NickeyJin/ZhiYuanZhanDui/docs/00-项目总览.md

# 00 项目总览

> 队伍：**致远战队**
> 机器人：四轮麦克纳姆轮全向底盘 + 四轴机械臂（拣放方块）
> 主控：STM32F103C8T6
> 遥控：PS2 无线手柄
> 文档约定：本目录内所有 `.md` 按「机器人功能完成的时间顺序」排列，每篇由若干**功能板块**组成
> （二级标题 = 功能名，正文 = 功能描述 + 开发历程）；开源项目说明见 `05-开源组件与参考资料.md`。

---

## 文档索引（按功能完成时间从早到晚）

| 文档 | 覆盖的功能板块 | 时间段 |
|---|---|---|
| [01-主控与电源平台.md](01-主控与电源平台.md) | 主控与调试接口 / 引脚分配 / 供电与共地 / 构建与烧录工具链 | 10-06 ~ 10-11 |
| [02-底盘与全向移动.md](02-底盘与全向移动.md) | 电机驱动与 PWM / 麦轮逆运动学 / 起步补偿 / 现场配速与整定 | 10-11 ~ 10-19 |
| [03-遥控与现场调参.md](03-遥控与现场调参.md) | PS2 手柄协议 / 微秒级时基 / 按键分工 / 现场调参旋钮 / 灯语 | 10-06 ~ 10-19 |
| [04-机械臂与夹取.md](04-机械臂与夹取.md) | 四路舵机与限位 / 上电初始位 / 放块宏 / 机械臂按键设计 | 10-15 ~ 10-19 |
| [05-开源组件与参考资料.md](05-开源组件与参考资料.md) | 第三方组件完整说明（规则要求的中期考核说明项） | — |

> 另有队友撰写的硬件侧日志《智能车设计与制作日志.md》（电源、PCB 底板、结构件、整车重量与成本），与本目录并存。

---

## 1. 简单介绍

一台用 PS2 手柄遥控的全向移动小车：底盘四个 60mm 麦克纳姆轮由 3 片 DRV8833 驱动 4 个 TT 减速电机，
可以前后、左右平移（存疑？）和原地自转；车上一只四舵机机械臂（肩 / 肘 / 腕 / 夹爪）负责把 30mm 立方体（能量单元）夹起并放进目标洞口，按一次 `R2+R1` 就能完成“回放块位 → 三轴到位 → 张爪丢块 → 回到原姿态”。

## 2. 设计约束（来自比赛规则）

| 约束 | 数值 | 对设计的影响 |
|---|---|---|
| 开局外形 | 高 ≤ 210mm | 机械臂必须能在开局收成平躺折叠姿态 |
| 运行中包络 | ≤ 445×400×450mm 或 550mm 球 | 臂展按“小臂 + 腕”分两段控制，不做大回转 |
| 整机重量 | ≤ 2.0kg | 机械臂选 MG995 + SG90 的轻量组合 |
| 抗跌落 | 150~200mm 自由落体不掉件 | 夹爪闭合位留 6mm 小孔靠摩擦夹持 |
| 成本 | 新生组不推荐超 400 元 | 结构件改现货、3D 打印件自制 |
| 断电 | 必须适配官方无线继电器（10m 内断电） | 列为收尾项 |

## 3. 时间线一览

| 日期 | 里程碑 |
|---|---|
| 10-06 ~ 10-08 | CubeMX 工程骨架、引脚分配、PS2 协议反查（无代码提交） |
| 10-10 | DWT 微秒延时（`dwt_delay.c`），PS2 软件时序的前提 |
| 10-11 | 首次提交：八路 PWM 底驱 + 单轮自检 + 手柄映射（`be97c94`） |
| 10-12 | 全向移动版：`vx/vy/ω` 麦轮逆解（`c858f51`） |
| 10-13 | `app.c` 拆分：`board.h`、`diag.c`，控制回路改成非阻塞 |
| 10-15 | 机械臂接入（`983eb4d`）：四路 TIM4 舵机 + 示教回放原型 |
| 10-16 | 夹爪实测标定（580~590µs 全闭 / 650~700µs 抓取 / 1000µs 全开） |
| 10-17 | 3D 打印机械臂放弃改现货；麦轮装反纠正；引入现场配速 |
| 10-18 | 代码精简、剥离示教模块、多固件并行编译、上电安全策略反转 |
| 10-19 凌晨 | 四路舵机限位现场标定；两连杆逆解试做后放弃 |
| 10-19 白天 | 底盘从零重构：PWM 改 1µs 分辨率、满速占空比 40%→80%、起步补偿 |
| 10-19 夜 | 肩限位重测（1072/1372µs）、上电初始位、`R2+R1` 放块宏、最终精简 |

## 4. 电控的碎碎念（已被折磨疯版）

又是凌晨了，已经有点力竭了。
回溯制作项目的过程中，其实，我自己好像基本上没有怎么写很长的代码，只是小的地方修修改改，大的地方交给AI，给它表示清楚需求，然后就放着不管了。
只能说，电控和编程还真的不是一回事情，至少，在这一个月左右的项目时期里，我学习到了很多调试的办法，知道了许多很奇怪的bug，也算是有收获吧。
所以，虽然这些文档里肯定会有AI的成分，但是，里面我还是加了不少的心路历程，还有bug调节的过程，以及为什么我想这么做。
无论结果如何，这都会是我一段难忘的经历。

——致远战队 电控 NickeyJin
