NickeyJin/ZhiYuanZhanDui/docs/05-开源组件与参考资料.md

# 05 开源组件与参考资料

> 依据比赛手册第 5 页：“将开源项目用于机器人的制作及代码编写是允许的，但必须在中期考核阶段给出完整说明。”
> 本篇为完整说明项。

## 1. 使用的第三方组件清单

| # | 名称 | 版本 / 出处 | 用途 | 是否修改 |
|---|---|---|---|---|
| 1 | STM32F1xx HAL Driver（STMicroelectronics） | **V1.1.10**（`Drivers/STM32F1xx_HAL_Driver/`，`__STM32F1xx_HAL_VERSION` 主/次/修订 = 01/01/0A） | GPIO、TIM、RCC 等外设驱动，`HAL_GetTick()` 时基 | 未修改，仅调用 |
| 2 | CMSIS-Core + STM32F1xx Device Headers | `Drivers/CMSIS/`（含 `LICENSE.txt`），`__CM3_REV 0x0200`（Cortex-M3 r2p0） | 寄存器定义、`CoreDebug` / `DWT`（微秒延时） | 未修改，仅调用 |
| 3 | STM32CubeMX 生成代码 | `MyFirstCar.ioc` / `.mxproject`；`main.c`、`stm32f1xx_hal_msp.c`、`stm32f1xx_it.c`、`system_stm32f1xx.c`、`syscalls.c`、`sysmem.c`、`startup_stm32f103xb.s` | 时钟与引脚初始化骨架 | **有修改**：在 USER CODE 区手写外设初始化；`.ioc` 多次同步（10-15 新增 PB6~PB9 四路 TIM4） |
| 4 | STM32CubeMX CMake 工程模板 | `cmake/stm32cubemx/CMakeLists.txt`、`cmake/gcc-arm-none-eabi.cmake`、`CMakePresets.json` | 构建系统 | **有修改**：源文件列表增删（机械臂模块加入后又移除） |
| 5 | GNU Tools for STM32 | **14.3.1+st.2**（ST 打包，`%LOCALAPPDATA%\stm32cube\bundles\gnu-tools-for-stm32\`） | 编译器 / 链接器 / `size` | 未修改 |
| 6 | STM32CubeProgrammer CLI | `STM32_Programmer_CLI.exe`（由 `build\tools\flash.ps1` 调用，经 ST-LINK / SWD 烧录） | 烧录与校验 | 未修改 |
| 7 | 链接脚本 `STM32F103xx_FLASH.ld` | CubeMX 默认模板 | 内存布局 | **有修改**： FLASH 64K→62K；新增 RAM `.persist` 段（复位不清零区）与 Flash 末尾 2 页数据区 |
| 8 | 塔克创新 PS2 无线手柄资料 | 《PS2 无线手柄使用指导手册 V1.0.3》《锁定款一键锁定使用说明 V1.0.0》；例程头文件 `ax_ps2.h` | **仅作协议对照**（位宽 16µs、命令 `0x01 0x42`、9 字节帧、`0x73/0x53` ID），未拷贝其代码 | 否 |
| 9 | 网络参考工程 | `github.com/twzffs/stm32_mecanum_car`、`github.com/xugit0000/car_template` | 检索过，因引脚与本板不符**未采用** | 否 |
| 10 | DWT 微秒延时写法 | 社区通行做法（`CoreDebug->DEMCR |= TRCENA` + `DWT->CYCCNT`） | `dwt_delay.c` | 本项目自行实现 |

## 2. 自研部分（声明为原创）

固件：`motor.c/h`、`chassis.c/h`、`ps2.c/h`、`app.c/h`、`board.h`、`tune.c/h`、`arm.c/h`、`dwt_delay.c/h`。

工具脚本：`build\tools\direct_build.ps1`、`flash.ps1`、`read_vars.ps1`。

## 3. 结论

**除 ST 官方 HAL / CMSIS / CubeMX 模板与 GNU 工具链外，本项目未引入任何第三方 C 库。**

PS2 手柄协议部分参考厂商手册自行实现（软件模拟时序，未使用硬件 SPI）；
麦轮逆运动学公式来自通用教材，代码中的量纲化简为本项目自行处理；
机械臂未使用实时逆解，姿态由现场标定后写成常量。

## 4. 参考资料

- 塔克创新《PS2 无线手柄使用指导手册 V1.0.3》《锁定款一键锁定使用说明 V1.0.0》
- STMicroelectronics《STM32F103x8/xB Datasheet》《RM0008 Reference Manual》
- STMicroelectronics《STM32F1xx HAL Driver 用户手册（UM1850）》
- CRTC2026 中期考核规则手册（物资表、尺寸/重量/成本/断电约束）
