NickeyJin/ZhiYuanZhanDui/docs/04-机械臂与夹取.md

# 04 机械臂与夹取

机械臂是 10-15 才接入的，却改动最频繁的部分：从“示教录制回放”一路收敛到“点动 + 上电初始位 + 一键放块宏”。

---

## 四路舵机与限位标定

### 功能描述

四个舵机接 **TIM4** 四通道，50Hz，脉宽 500~2500µs（0°~180° 舵机）：

| 通道 | 引脚 | 关节 | 软限位（µs） | 点动速度（µs/s） |
|---|---|---|---|---|
| ch0 | PB6 （TIM4_CH1） | 肩（大臂） | 1082 ~ 1800 | 600 |
| ch1 | PB7 （TIM4_CH2） | 肘（小臂） | 700 ~ 2500 | 700 |
| ch2 | PB8 （TIM4_CH3） | 腕 | 630 ~ 2390 | 700 |
| ch3 | PB9 （TIM4_CH4） | 夹爪 | 570 ~ 1330 | 900 |

所有运动都是“改目标值 + 每拍朝目标走一小步”（`arm_move_tick()`），所以是平滑走过去，不是瞬移。
每一步的速度即上表的 µs/s；按住 L1 为 1/3 速、R1 为 3 倍速。

### 开发历程

- 10-15 21:20 另外一个电控队友提交git，带来 628 行的 `servo.c`（软限位 + 缓动）和 659 行的 `teach_only.c`
（示教录制 + Flash 存取），并把链接脚本 **FLASH 64K→62K**，让出最后 2 页（`0x0800F800`，2KB） 存录制数据。
- 10-16 审查队友代码时找到一个bug: **夹爪开机一直堵住不转**——`servo.c` 里 `oc.Pulse = 1500`被 `servo_hw_init()` 直接下发到四路 CCR，上电瞬间全部输出 1.5ms 并保持。
（也是因此，我知道了1500，只是常规安全位置，还是需要具体问题具体分析，找到合适这个舵机的量）
  改进的办法是“上电先松劲，按 `SELECT+START` 才通电”。（这个也沿用到今天）

---

## 上电初始位（抓取姿态）

### 功能描述

`SELECT + START` 通电时，四路直接走到“钩爪完全闭合的抓取姿态”（`arm.h` 常量）：

```c
ARM_US_INIT_SH 1082   /* 肩：最高点（实测值）  */
ARM_US_INIT_EL 2500   /* 肘：最里 */
ARM_US_INIT_WR 2004   /* 腕：爪口朝下 */
ARM_US_INIT_GR 570    /* 爪：完全闭合 */
```

### 开发历程

- 本质上就是要一个**固定的默认初始位置**，上电即到位、不用现场摆，数据的话从read_vars.ps1里拿。
- 设计取舍：**上电默认松劲**（`SELECT+START` 才通电）。如果一上电就通电追位，机械臂可能还在包装/收纳姿态，舵机会硬顶着把结构扭坏。（实际上已经因为这个，把一个3D打印件给弄爆炸了，qwq）

---

## 放块宏（`R2 + R1`）

### 功能描述

一次按键完成“放块”： **记住当前姿态 → 走到放块位 → 前三轴到位后张爪丢块 → 回到按键之前的姿态**。

```c
ARM_US_PUT_SH 1082  ARM_US_PUT_EL 2500  ARM_US_PUT_WR 2004   /* 放块位（与初始位同一点）  */
ARM_US_PUT_GR_OPEN  1330    /* 张爪到全开 */
ARM_PUT_HOLD_MS     400     /* 张爪保持 400ms，保证方块落下 */
ARM_PUT_ARRIVE_US   8       /* 到位判据：|当前 - 目标| ≤ 8µs */
ARM_PUT_TIMEOUT_MS  6000    /* 安全超时：6s 还没到位就放弃 */
```

状态机四态：`PUT_IDLE → PUT_MOVE（三轴走向放块位）  → PUT_OPEN（张爪、保持）  → PUT_BACK（四路回到按键前姿态） `。宏运行期间其它按键被忽略，防止半途被点动打乱。

### 开发历程

其实，这个我其实是没有能力完成的，所以，我让AI帮助我完成了这一块的逻辑。的确有这么一个自动放回装置方便了很多。
功能需求：拾起方块后按 `R2+R1` 自动回到那个位置，**前三个都到位之后爪子才自动开启丢块**，然后回到按 `R2+R1` 之前的舵机状态。

---

## 机械臂按键与安全策略

### 功能描述

| 按键 | 动作 |
|---|---|
| ↑ / ↓ | 肩抬 / 肩落（脉宽变大是往下，所以按键方向已对调成“↑ = 抬起”） |
| ← / → | 肘收 / 肘伸 |
| △ / × | 腕上 / 腕下 |
| □ / ○ | 爪闭合 / 爪张开 |
| 按住 L1 / R1 | 点动 1/3 速 / 3 倍速 |
| SELECT + START | 四路通电 / 松劲 |
| R2 + R1 | 放块宏 |
| START | 整车急停（底盘停 + 臂松劲，灯慢闪） |

### 开发历程

- 一开始，之所以有这个，是因为机械臂刚刚装好，需要调试，于是乎有了前4行
- 在测试等等过程中，我发现有的地方需要微调，因此，引入了L1，从而进行精细化拾取操作
- 在测试的过程中，我觉得要是每次抓取都一点点自己操作收回去，那也太麻烦了，于是就有了“放块宏”
