NickeyJin/ZhiYuanZhanDui/docs/历史归档/README.md

# 历史归档

这里放开发过程中临时写下的记录，**只为留痕，不能当作现行说明使用**——
其中不少键位、模块名、参数在 10-19 的最终精简里已经作废。

| 文件 | 当时是什么 | 现在还能用吗 |
|---|---|---|
| [机械臂接入说明.md](机械臂接入说明.md) | 10-15 机械臂第一次接入时的模块说明（`servo.c`/`teach_only.c` 体系） | ❌ 这两个模块已在 10-18 移除，现行实现是 `arm.c/h` |
| [机械臂操作卡.md](机械臂操作卡.md) | 10-19 凌晨的操作卡（含录制/回放、限位微调键） | ❌ 录制回放与限位微调键已删除，现行键位见 [`../04-机械臂与夹取.md`](../04-机械臂与夹取.md) 与仓库根 `README.md` |
| [机械臂明日清单.md](机械臂明日清单.md) | 10-17 的待办清单与尺寸/成本核算 | ⚠️ 待办已完成，尺寸与成本数据仍可参考 |
| [舵机标定记录.md](舵机标定记录.md) | 10-19 凌晨四路舵机标定表（旧通道命名：CH1 底座旋转 / CH2 肩 / CH3 肘 / CH4 爪） | ⚠️ 数据可参考，但**通道编号与现行 `arm.h` 不同**（现行 CH1 肩 / CH2 肘 / CH3 腕 / CH4 爪）；肩的限位 10-19 夜已重测为 1072/1372µs |

需要的现行参数一律以 `Core/Inc/arm.h`、`Core/Inc/app.h`、`Core/Inc/motor.h` 的注释为准。
