NickeyJin/ZhiYuanZhanDui/docs/历史归档/舵机标定记录.md

# 舵机标定记录

> 板子里存的是 RAM（`.persist` 段），**断电就没了**。每次读出来的数据都抄到这里，免得白测。
> 读数据命令：
> ```
> powershell -NoProfile -ExecutionPolicy Bypass -File build\tools\ps2test_read.ps1 -Elf build\servotest\MyFirstCar.elf
> ```

## 2026-10-19 00:19（固件 SVT3 `0x53565433`）

| 通道 | 引脚 | 最后停的位置 `t_sv_now` | 上限 `t_sv_up` | 下限 `t_sv_dn` | 行程耗时 `t_sv_span_ms` | 方向对调 `t_sv_rev` |
|---|---|---|---|---|---|---|
| 1 | PB6 (TIM4_CH1) | **1120 µs** | 未记 | 未记 | — | 否 |
| 2 | PB7 (TIM4_CH2) | **1900 µs** | 未记 | 未记 | — | 否 |
| 3 | PB8 (TIM4_CH3) | **1160 µs** | 未记 | 未记 | — | 否 |
| 4 | PB9 (TIM4_CH4) | **1040 µs** | 未记 | 未记 | — | 否 |

- 上电初始位置 `t_sv_init` = 1500 / 1500 / 1500 / 1500（四路都还是默认值，没改过 `SV_FIRST_US`）
- 速度 `t_sv_speed` = 20（默认，没调过）
- 结束时四路都是松劲状态（`t_sv_on = [0,0,0,0]`）
- **结论：只记录了"最后停的位置"，△/× 一个限位都没记下来。**

## 2026-10-19 00:22（固件 SVT3，用户标了第 3 路）

| 通道 | 引脚 | 最后位置 `t_sv_now` | 上限 `t_sv_up`(△) | 下限 `t_sv_dn`(×) | 行程耗时 `t_sv_span_ms` | 方向对调 |
|---|---|---|---|---|---|---|
| 1 | PB6 | 1120 µs | 未记 | 未记 | — | 否 |
| 2 | PB7 | 2080 µs | 未记 | 未记 | — | 否 |
| 3 | PB8 (TIM4_CH3) | 2400 µs | **620 µs** | **2400 µs** | 13100 ms | 否 |
| 4 | PB9 | 1040 µs | 未记 | 未记 | — | 否 |

- `t_sv_sel = 3`（确实停在第 3 路），`t_sv_speed = 20`（没调过），`t_sv_rev` 全 0。
- **第 3 路两端都记上了**：620 µs ↔ 2400 µs，行程 1780 µs。
- 疑点 ①：2400 µs 正好等于软件硬窗口上限 `SV_MAX_US`，很可能**没碰到真机械死点、是被软件卡住的**。
- 疑点 ②：`t_sv_span_ms = 13100` 不能当速度用 —— 13100 ms 里包含了停顿和手动按键的时间；速度 20（1000 µs/秒）走 1780 µs 本来只要约 1.8 秒。测真实速度必须一口气按住不放。

## 2026-10-19 00:29（四路全部记完 · 用户确认都是 180° 舵机）

| 通道 | 引脚 | 关节（按用户图上从左到右） | △ 记的 | × 记的 | 行程 | 估算角度* | 现在停在哪 |
|---|---|---|---|---|---|---|---|
| 1 | PB6 (TIM4_CH1) | 底座旋转 | 1182 µs | 1514 µs | 332 µs | ≈30° | 1130 µs |
| 2 | PB7 (TIM4_CH2) | 肩（大臂） | 2372 µs | 764 µs | 1608 µs | ≈145° | 764 µs |
| 3 | PB8 (TIM4_CH3) | 肘（小臂） | 620 µs | 2400 µs | 1780 µs | ≈160° | 1668 µs |
| 4 | PB9 (TIM4_CH4) | 夹爪 | 1340 µs | 560 µs | 780 µs | ≈70° | 716 µs |

\* 角度按 2000 µs = 180°（0.09°/µs）粗算，**未经量角器标定，只能当量级看**。

- 四路都是"△ 和 × 都有值"，说明每路两端都记上了。
- `t_sv_speed = 12`（调过速度），`t_sv_sel = 2`，`t_sv_rev` 全 0（方向都没对调），四路都松劲。
- `t_sv_span_ms` = [34900, 30560, 13100, 6640]：**含停顿和手动按键时间，不能当速度用**。
- 疑点 ①：第 3 路的 2400 µs 正好等于软件硬窗口上限 `SV_MAX_US`，可能没碰到真机械死点。
- 疑点 ②：第 1 路只有 332 µs（≈30°），对"底座旋转"来说偏小，要确认是机械只能转这么多，还是当时没拧到端点。

### 待办
- [ ] 每一路重新标：慢速逼近 → 听到堵转嗡鸣 → 回退 20~50µs → 按 △ / × 记（按下时灯快闪 4 下才算记上）
- [ ] 记完对比 `t_sv_span_ms` 反推舵机真实速度
- [ ] 四路齐了以后换算角度，写死进机械臂代码
