NickeyJin/ZhiYuanZhanDui/(commit log)

2026-10-19 docs: 合并中期考核设计文档（致远战队）
2026-10-19 docs: 补充速度模式适用场景与机械臂半自动收回
2026-10-19 docs: 补充集成底板原理图与 PCB 版图
2026-10-19 同步当前固件与开发文档
    - 固件：机械臂重写为 arm.c/h（四路点动 / 上电初始位 / R2+R1 放块宏）、
    新增 tune.c/h（总速度 / 单轮补偿 / 前后配平现场旋钮 + 灯语）；
    删除 diag/servo/teach_only 三个旧模块与自检、诊断、录制回放等测试代码
    - 修复 app_init 漏调 tune_init()/arm_init() 导致 .persist 未初始化的问题
    - 文档：docs/ 新增 00~05 六篇固件开发日志（按功能板块、按完成时间排列），
    docs/历史归档/ 收纳早期临时清单；README 按当前固件重写（引脚 / 键位 / 编译烧录 / 参数位置）
    - 构建脚本改为可移植路径（ARM_GCC_BIN 或 STM32Cube 工具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
    [MyFirstCar.ioc, app.c, app.h, arm.c, arm.h, board.h, chassis.c, chassis.h]
2026-10-19 docs: 更正开源说明中固件源码位置的表述
2026-10-19 docs: 按队伍文档重写语言合并，统一全角标点，补充电控手记
